ZHoob2004/Polygonus-Universal-112/README.md

# Polygonus-Universal

Basic pinout for the Molex 112 pin plug intended for universal use.  

## NOT COMPATIBLE WITH ANY PNP APPLICATION  
 
## V1.0 ready for first fabrication, please check BOM before fabrication
 
## Pre-Production well tested and proven
