ZHoob2004/Polygonus-Universal-112/kicad-libraries/BOM_related/Kicad_BOM_Not_grouped_Frankenso.png

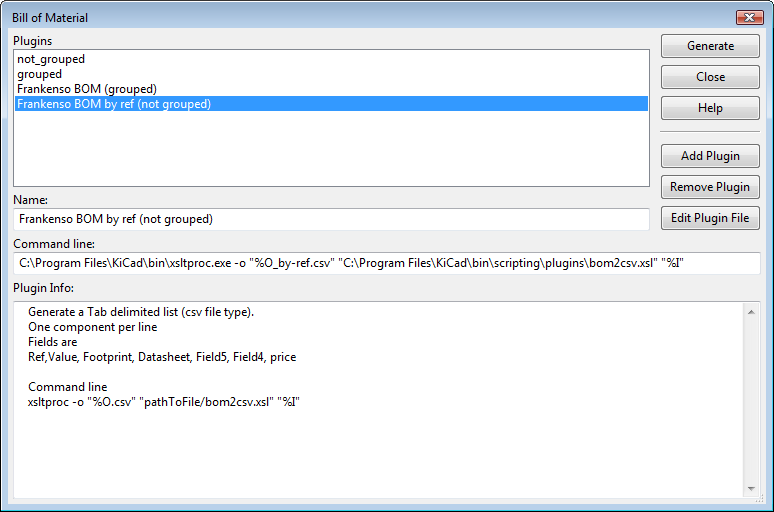
kicad-libraries/BOM_related/Kicad_BOM_Not_grouped_Frankenso.png
