ZHoob2004/Polygonus-Universal-112/CAD/STEP/Base.stp

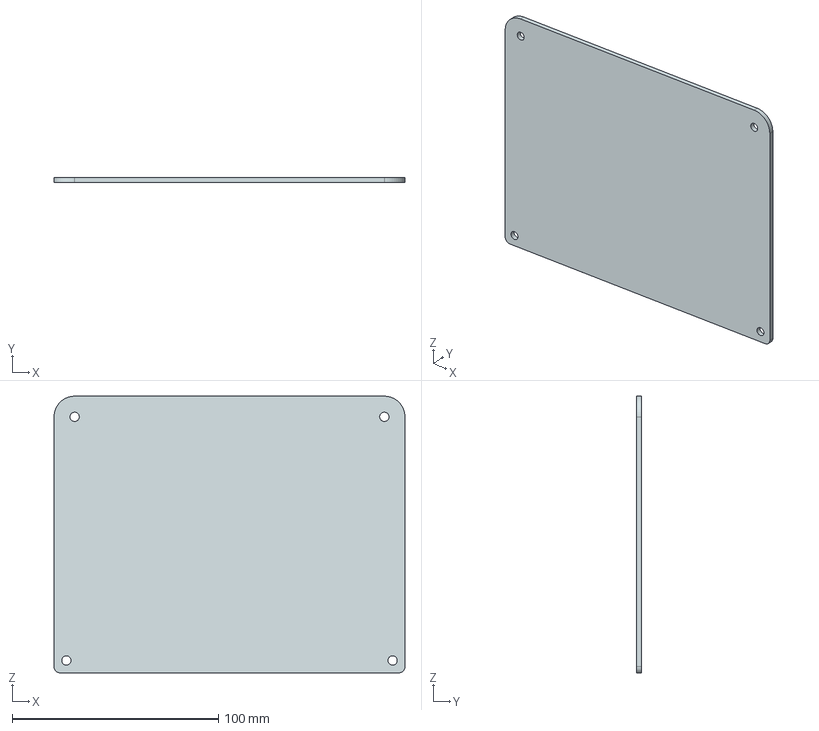
[picture p5: CAD file, 2025-05-16]
CAD/STEP/Base.stp
170.0 x 2.50 x 134.0 mm
