ZHoob2004/Polygonus-Universal-112/kicad-libraries/3d/Misc/drv8880-stepper-motor-driver-carrier.FCStd

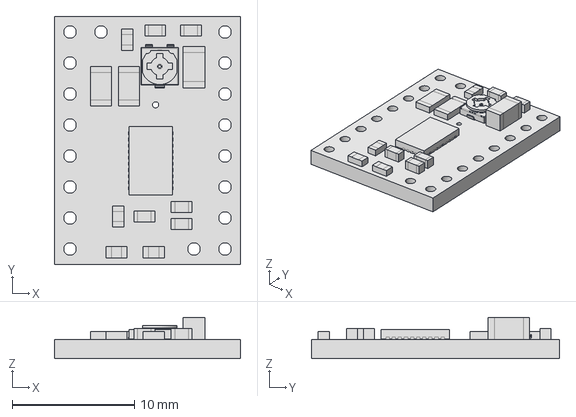
[picture p6: CAD file, 2024-04-05]
kicad-libraries/3d/Misc/drv8880-stepper-motor-driver-carrier.FCStd
15.2 x 20.3 x 3.37 mm
