ZHoob2004/Polygonus-Universal-112/kicad-libraries/3d/TSOP-6.step

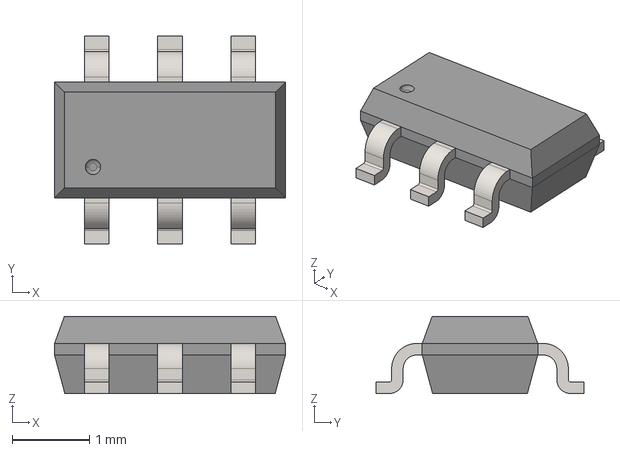
[picture p7: CAD file, 2024-04-05]
kicad-libraries/3d/TSOP-6.step
3.00 x 2.70 x 1.00 mm
