ZHoob2004/Polygonus-Universal-112/CAD/STEP/PCB.stp

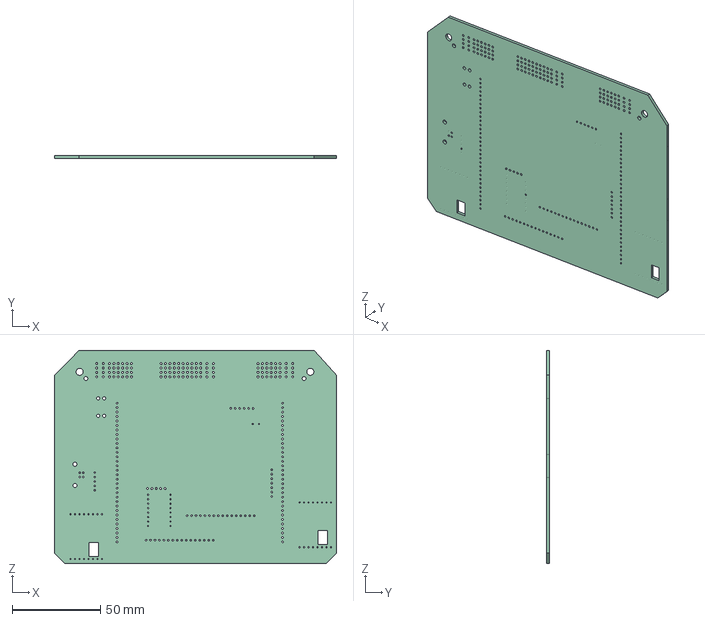
[picture p8: CAD file, 2025-05-16]
CAD/STEP/PCB.stp
160.0 x 1.58 x 121.0 mm
