ZHoob2004/Polygonus-Universal-112/kicad-libraries/3d/Misc/a4988-stepper-motor-driver-carrier.FCStd

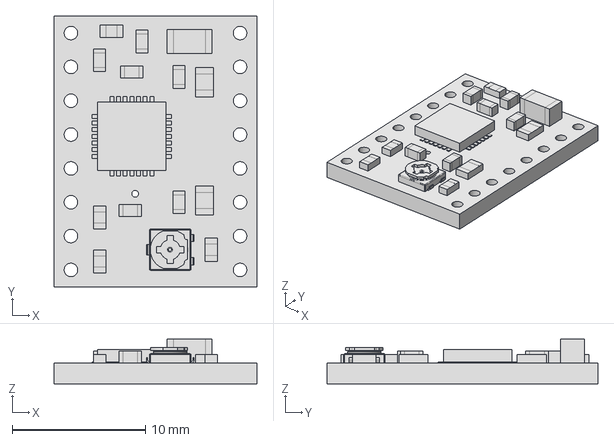
[picture p9: CAD file, 2024-04-05]
kicad-libraries/3d/Misc/a4988-stepper-motor-driver-carrier.FCStd
15.2 x 20.3 x 3.37 mm
