ZHoob2004/Polygonus-Universal-112/kicad-libraries/3d/TCPL_CONNECTOR_PCC-SMP.step

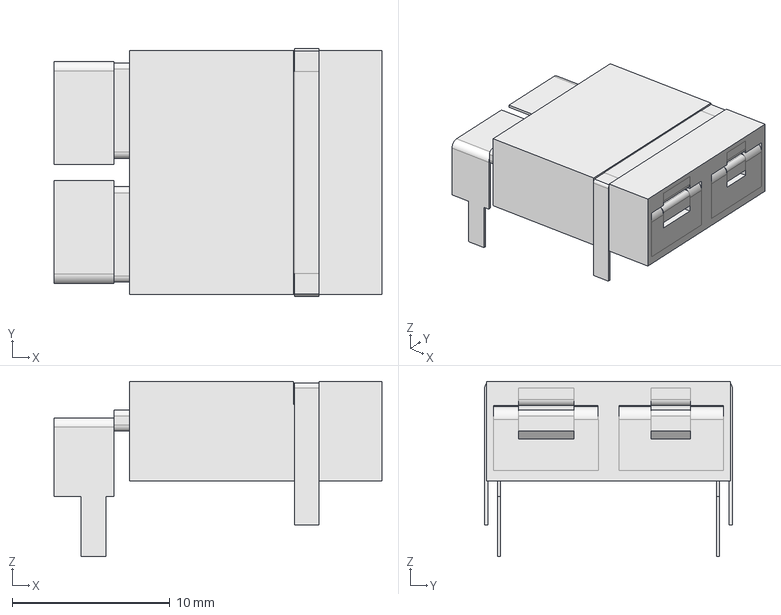
[picture p10: CAD file, 2024-04-05]
kicad-libraries/3d/TCPL_CONNECTOR_PCC-SMP.step
20.8 x 15.7 x 11.1 mm
