ZHoob2004/Polygonus-Universal-112/kicad-libraries/3d/c-1-776231-1-d-3d.STEP

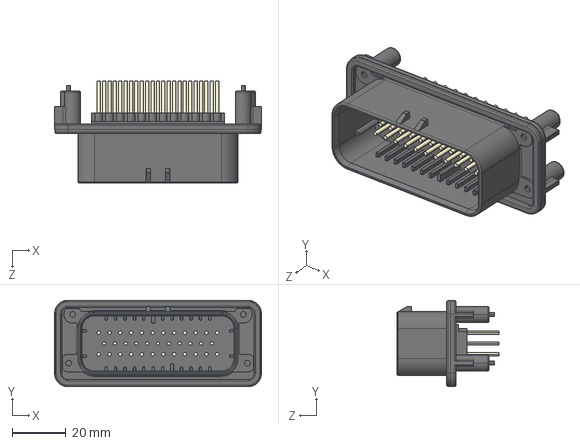
[picture p11: CAD file, 2024-04-05]
kicad-libraries/3d/c-1-776231-1-d-3d.STEP
76.9 x 32.1 x 38.0 mm
