ZHoob2004/Polygonus-Universal-112/CAD/STEP/Upper.stp

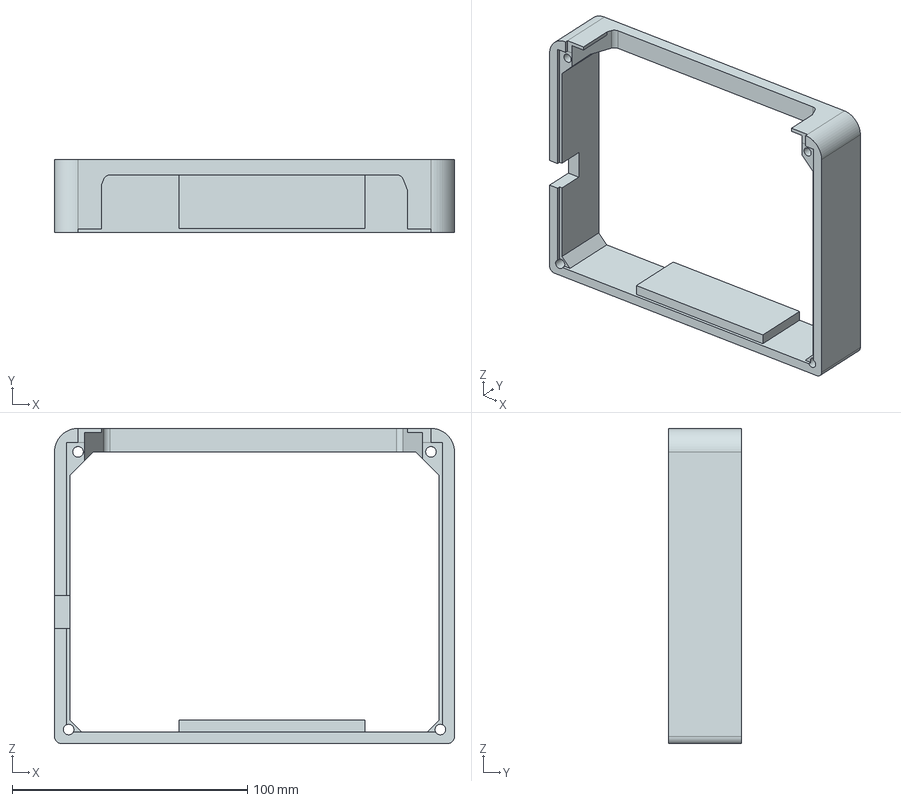
[picture p12: CAD file, 2025-05-16]
CAD/STEP/Upper.stp
170.0 x 31.0 x 134.0 mm
