ZHoob2004/Polygonus-Universal-112/kicad-libraries/3d/tactileswitch-short.step

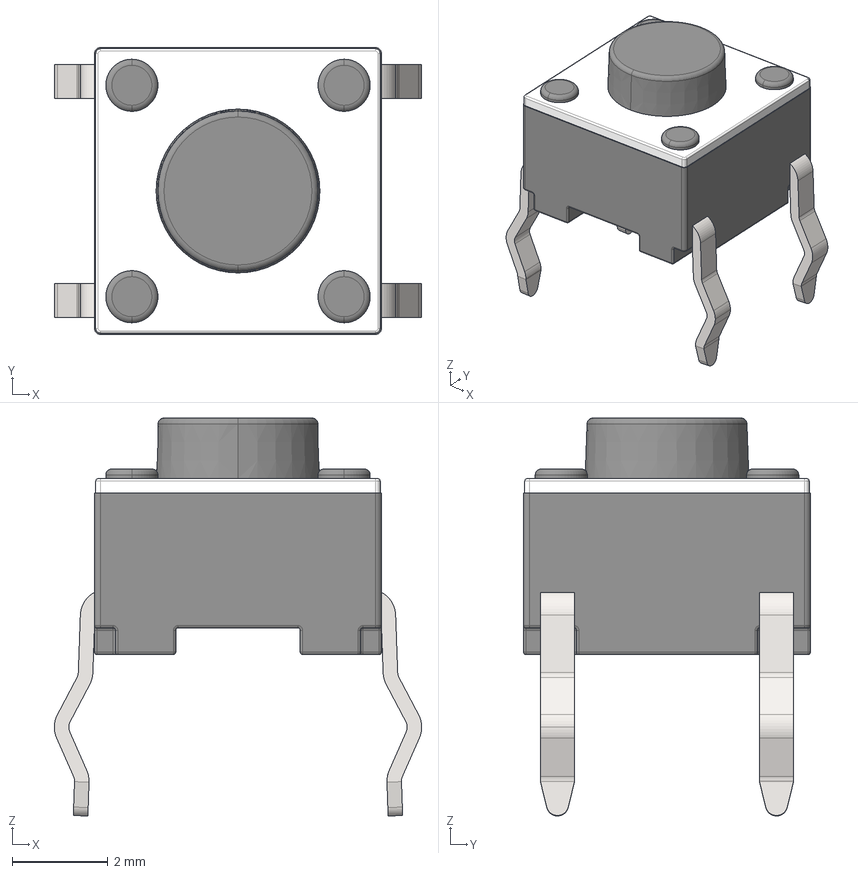
[picture p13: CAD file, 2024-04-05]
kicad-libraries/3d/tactileswitch-short.step
7.69 x 6.01 x 8.33 mm
