ZHoob2004/Polygonus-Universal-112/CAD/STEP/Lower.stp

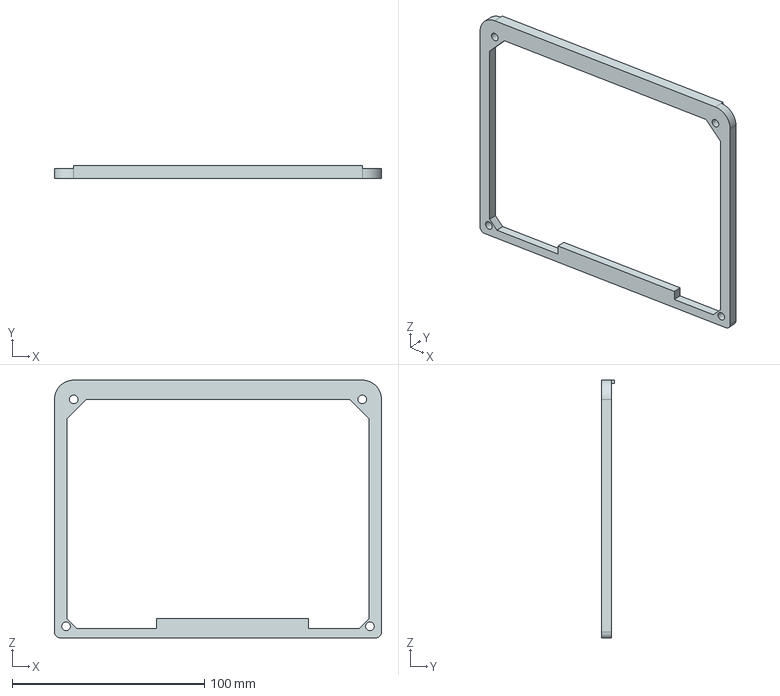
[picture p14: CAD file, 2025-05-16]
CAD/STEP/Lower.stp
170.0 x 6.50 x 134.0 mm
