ZHoob2004/Polygonus-Universal-112/kicad-libraries/3d/BatHolder_SMTU2032.step

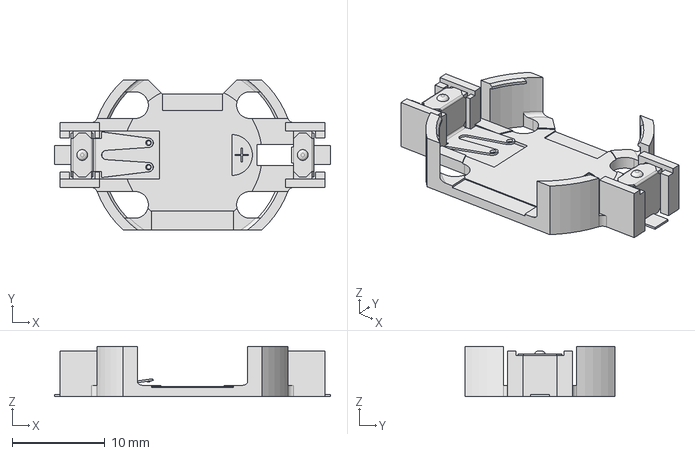
[picture p15: CAD file, 2024-04-05]
kicad-libraries/3d/BatHolder_SMTU2032.step
29.7 x 16.1 x 5.40 mm
