ZHoob2004/Polygonus-Universal-112/kicad-libraries/3d/USB_Vert_C-1734753-1.step

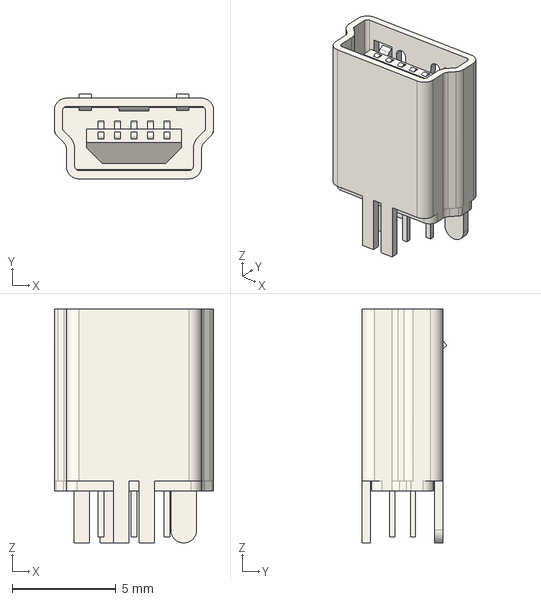
[picture p16: CAD file, 2024-04-05]
kicad-libraries/3d/USB_Vert_C-1734753-1.step
7.70 x 4.09 x 11.3 mm
