ZHoob2004/Polygonus-Universal-112/kicad-libraries/3d/HC18U.step

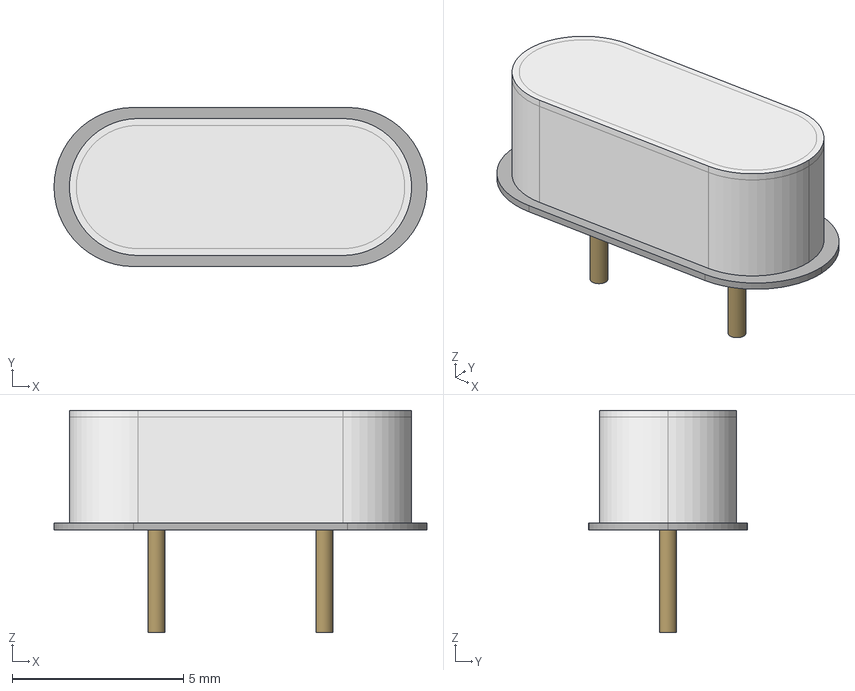
[picture p17: CAD file, 2024-04-05]
kicad-libraries/3d/HC18U.step
10.9 x 4.65 x 6.50 mm
