ZHoob2004/Polygonus-Universal-112/kicad-libraries/3d/MPD_CR2032.STEP

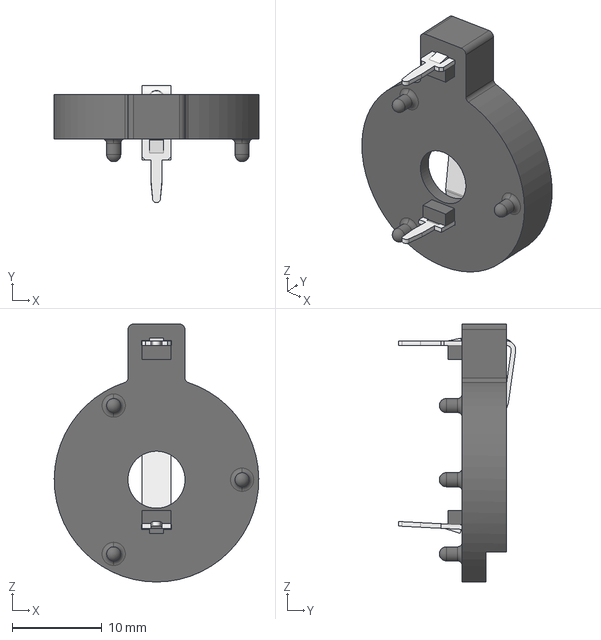
[picture p18: CAD file, 2024-04-05]
kicad-libraries/3d/MPD_CR2032.STEP
22.8 x 13.1 x 28.7 mm
