ZHoob2004/Polygonus-Universal-112/kicad-libraries/3d/itead_hc-05.step

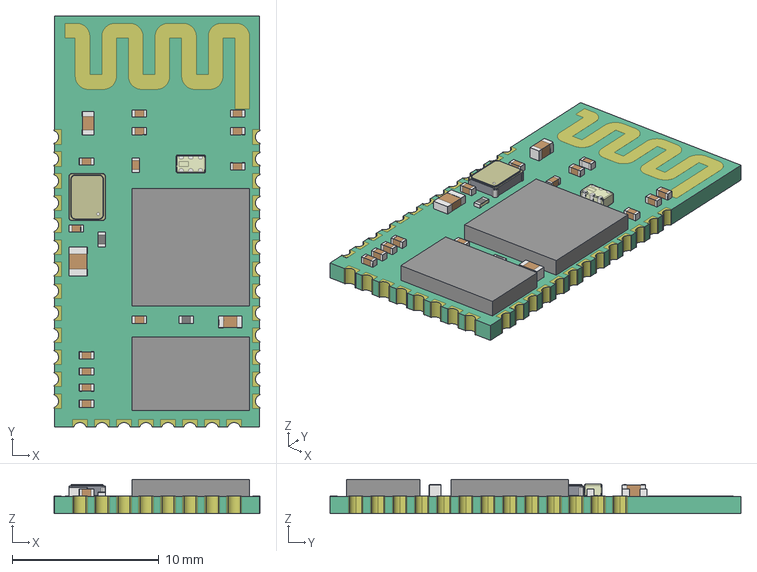
[picture p19: CAD file, 2024-04-05]
kicad-libraries/3d/itead_hc-05.step
14.0 x 28.0 x 2.35 mm
