ZHoob2004/Polygonus-Universal-112/kicad-libraries/3d/AMPSEAL_35_RIGHT_ANGLE.STEP

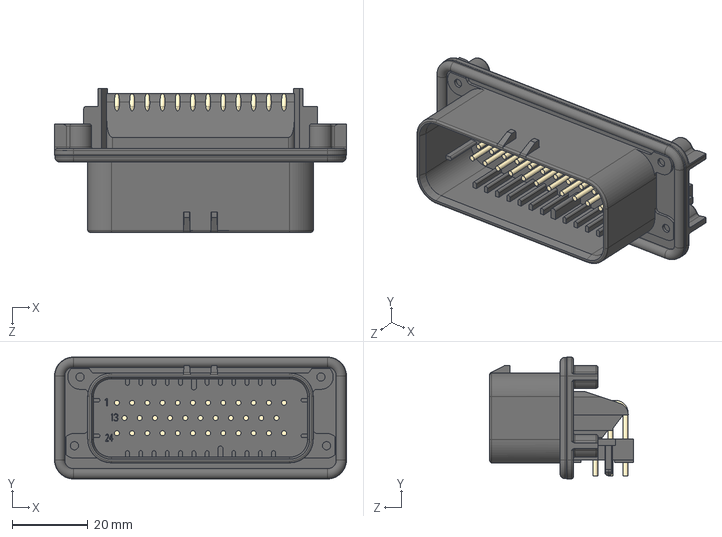
[picture p20: CAD file, 2024-04-05]
kicad-libraries/3d/AMPSEAL_35_RIGHT_ANGLE.STEP
76.9 x 32.1 x 37.8 mm
