ZHoob2004/Polygonus-Universal-112/kicad-libraries/3d/micro_sd.step

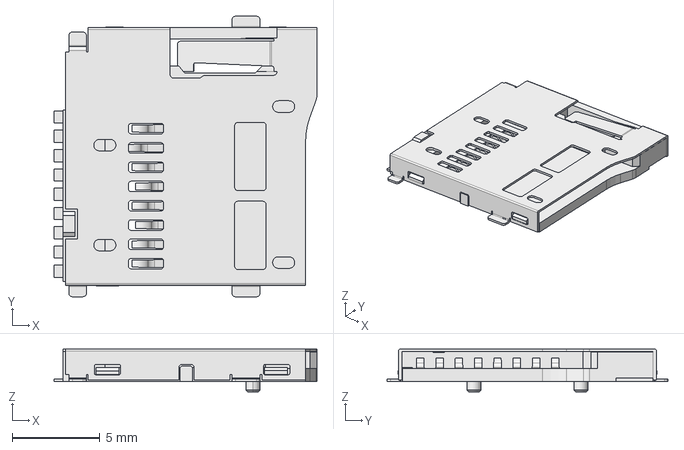
[picture p21: CAD file, 2024-04-05]
kicad-libraries/3d/micro_sd.step
15.0 x 16.0 x 2.44 mm
