ZHoob2004/Polygonus-Universal-112/kicad-libraries/3d/keystone-3557.step

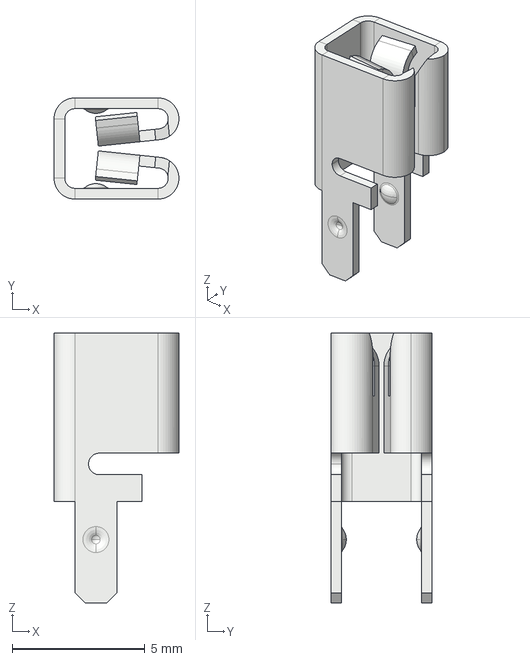
[picture p22: CAD file, 2024-04-05]
kicad-libraries/3d/keystone-3557.step
4.70 x 3.81 x 10.2 mm
