ZHoob2004/Polygonus-Universal-112/kicad-libraries/3d/JoyStick_SKRHAA.step

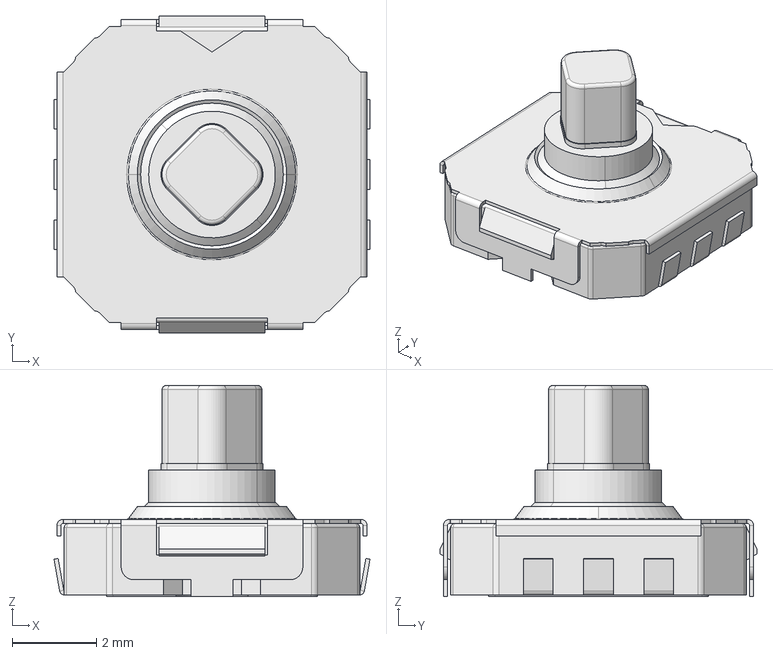
[picture p23: CAD file, 2024-04-05]
kicad-libraries/3d/JoyStick_SKRHAA.step
7.48 x 7.50 x 5.00 mm
