ZHoob2004/Polygonus-Universal-112/kicad-libraries/3d/LCD_20x4.step

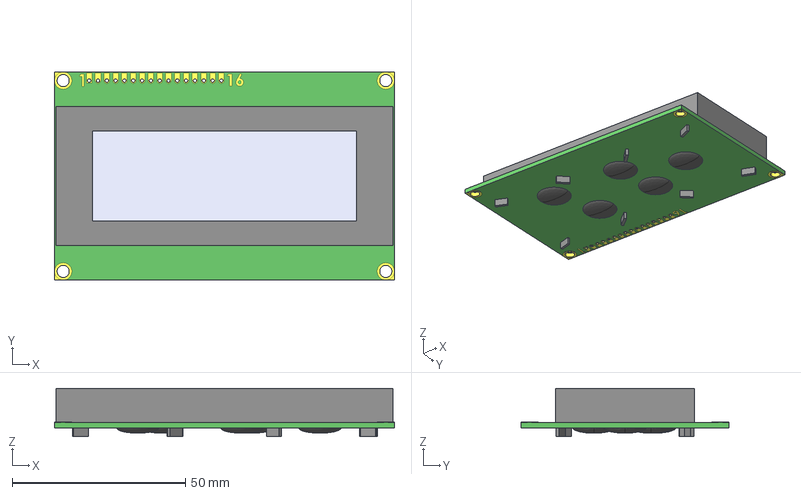
[picture p24: CAD file, 2024-04-05]
kicad-libraries/3d/LCD_20x4.step
98.0 x 60.0 x 13.9 mm
