ZHoob2004/Polygonus-Universal-112/kicad-libraries/3d/LED_0805.step

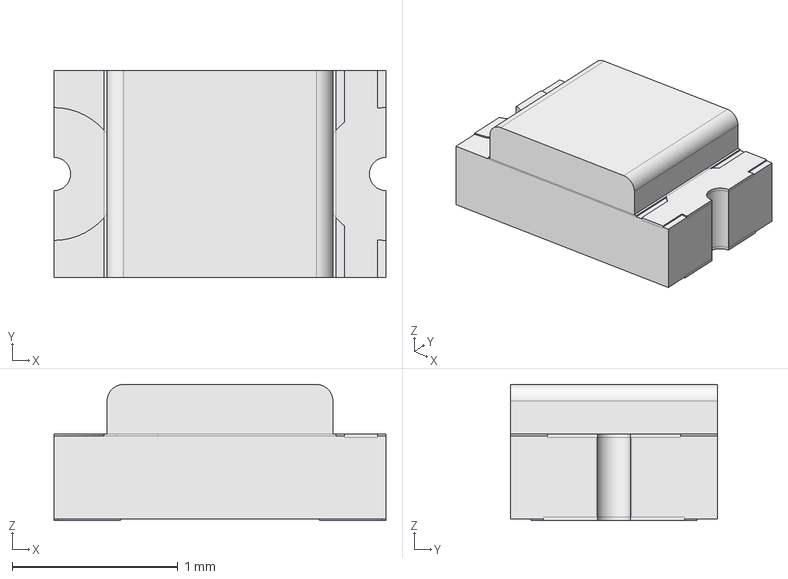
[picture p25: CAD file, 2024-04-05]
kicad-libraries/3d/LED_0805.step
2.00 x 1.25 x 0.82 mm
