ZHoob2004/Polygonus-Universal-112/kicad-libraries/3d/c-1-776228-1-e-3d.STEP

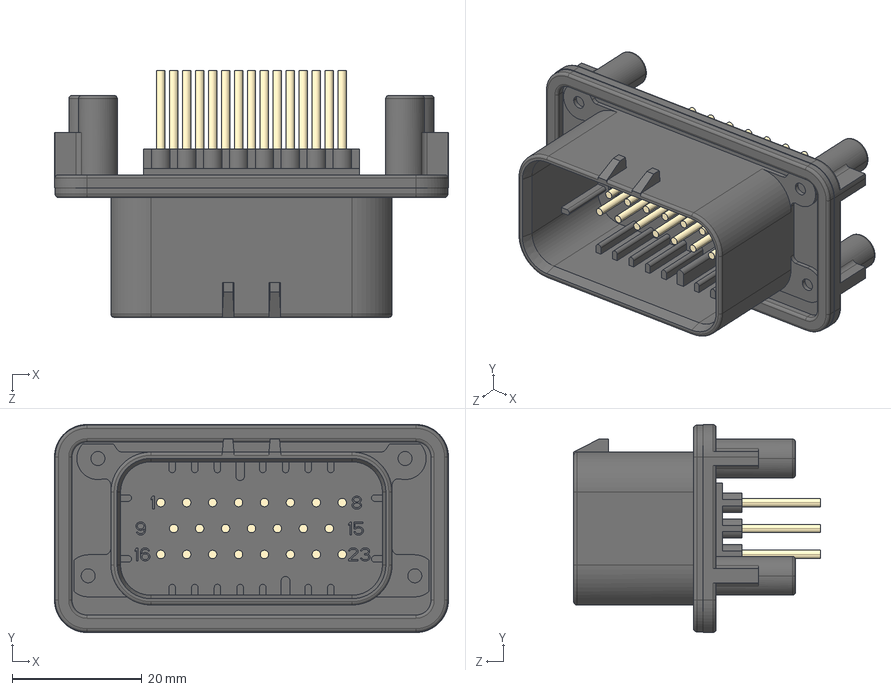
[picture p26: CAD file, 2024-04-05]
kicad-libraries/3d/c-1-776228-1-e-3d.STEP
60.8 x 32.1 x 38.1 mm
