ZHoob2004/Polygonus-Universal-112/(list of files, cad)

Other CAD files:
CAD/STEP/FPP_Lid.stp
kicad-libraries/3d/c-1-776231-2-d-3d.STEP
kicad-libraries/3d/AMPSEAL_35_STRAIGHT.STEP
kicad-libraries/3d/AMPSEAL_23_STRAIGHT.stp
CAD/stl/Base.stl
CAD/stl/FPP_Lid.stl
CAD/stl/Lower.stl
CAD/stl/PCB.stl
CAD/stl/Upper.stl
kicad-libraries/3d/LCD_20x4.FCStd
kicad-libraries/3d/MPD_CR2032.FCStd
kicad-libraries/3d/Misc/a4988-stepper-motor-driver-carrier.stl
kicad-libraries/3d/Misc/drv8880-stepper-motor-driver-carrier.stl
