ZHoob2004/Polygonus-Universal-112/kicad-libraries/HiQUAD64_footprint_builder.png

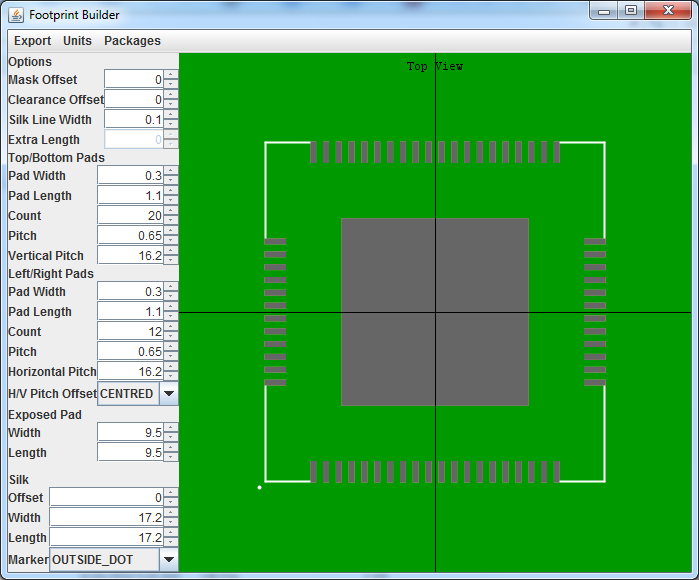
kicad-libraries/HiQUAD64_footprint_builder.png
