ZHoob2004/Polygonus-Universal-112/IGBT outputs.kicad_sch

## KiCad design IGBT outputs.kicad_sch (2025-10-27, an earlier design)

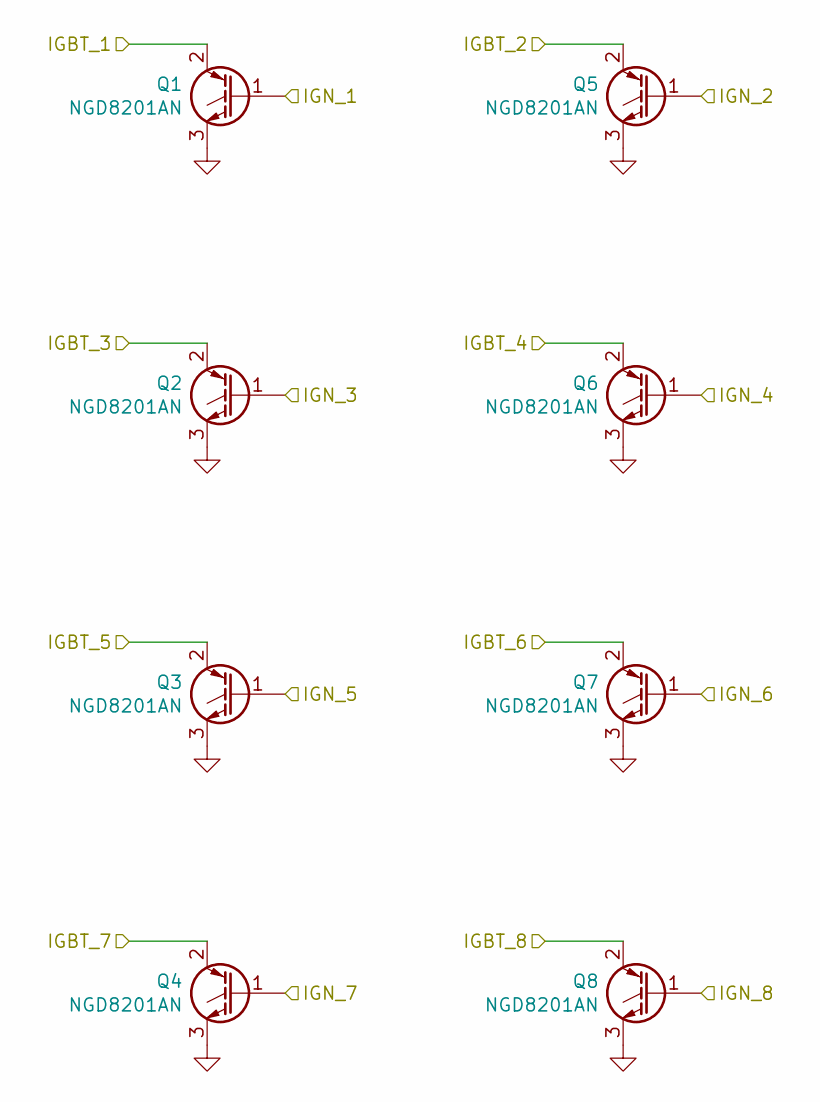
[picture p48: schematic IGBT outputs.kicad_sch]

Parts:
Q1, Q2, Q3, Q4, Q5, Q6, Q7, Q8: NGD8201AN; TO-252-2; LCSC C151649

Connections:
GND: Q1.3 (E), Q2.3 (E), Q3.3 (E), Q4.3 (E), Q5.3 (E), Q6.3 (E), Q7.3 (E), Q8.3 (E)
IGBT_1: Q1.2 (C)
IGBT_2: Q5.2 (C)
IGBT_3: Q2.2 (C)
IGBT_4: Q6.2 (C)
IGBT_5: Q3.2 (C)
IGBT_6: Q7.2 (C)
IGBT_7: Q4.2 (C)
IGBT_8: Q8.2 (C)
IGN_1: Q1.1 (G)
IGN_2: Q5.1 (G)
IGN_3: Q2.1 (G)
IGN_4: Q6.1 (G)
IGN_5: Q3.1 (G)
IGN_6: Q7.1 (G)
IGN_7: Q4.1 (G)
IGN_8: Q8.1 (G)
