ZHoob2004/Polygonus-Universal-112/Lowside Adder.kicad_sch

## KiCad design Lowside Adder.kicad_sch (2025-10-27, an earlier design)

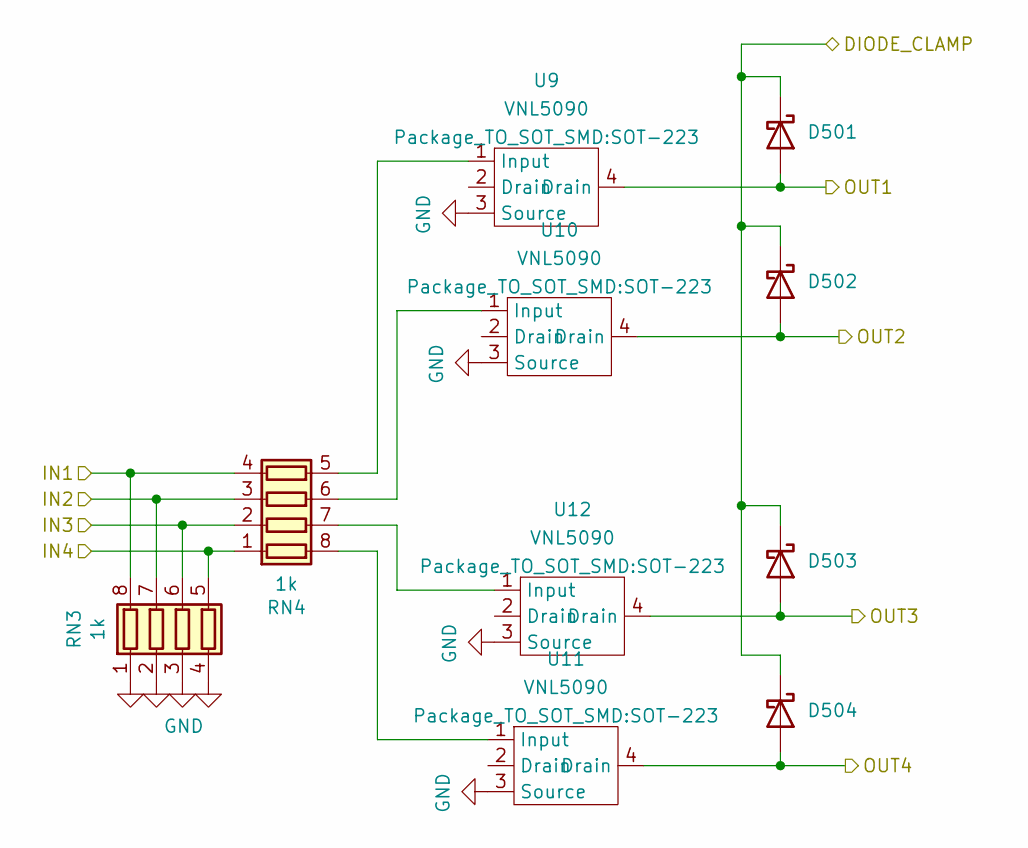
[picture p49: schematic Lowside Adder.kicad_sch]

Parts:
D501, D502, D503, D504: D_Schottky; D_SMA
RN3, RN4: 1k; R_Array_Convex_4x0603; LCSC C20197
U9, U10, U11, U12: VNL5090; SOT-223; LCSC C2680415

Connections:
DIODE_CLAMP: D501.1 (K), D502.1 (K), D503.1 (K), D504.1 (K)
GND: RN3.1 (R1.1), RN3.2 (R2.1), RN3.3 (R3.1), RN3.4 (R4.1), U9.3 (Source), U10.3 (Source), U11.3 (Source), U12.3 (Source)
IN1: RN3.8 (R1.2), RN4.4 (R4.1)
IN2: RN3.7 (R2.2), RN4.3 (R3.1)
IN3: RN3.6 (R3.2), RN4.2 (R2.1)
IN4: RN3.5 (R4.2), RN4.1 (R1.1)
unnamed: RN4.5 (R4.2), U9.1 (Input)
unnamed: RN4.6 (R3.2), U10.1 (Input)
unnamed: RN4.7 (R2.2), U12.1 (Input)
unnamed: RN4.8 (R1.2), U11.1 (Input)
OUT1: D501.2 (A), U9.4 (Drain)
OUT2: D502.2 (A), U10.4 (Drain)
OUT3: D503.2 (A), U12.4 (Drain)
OUT4: D504.2 (A), U11.4 (Drain)
