ZHoob2004/Polygonus-Universal-112/Polygonus-Universal-Base.kicad_sch

## KiCad design Polygonus-Universal-Base.kicad_sch (2025-10-27, an earlier design)

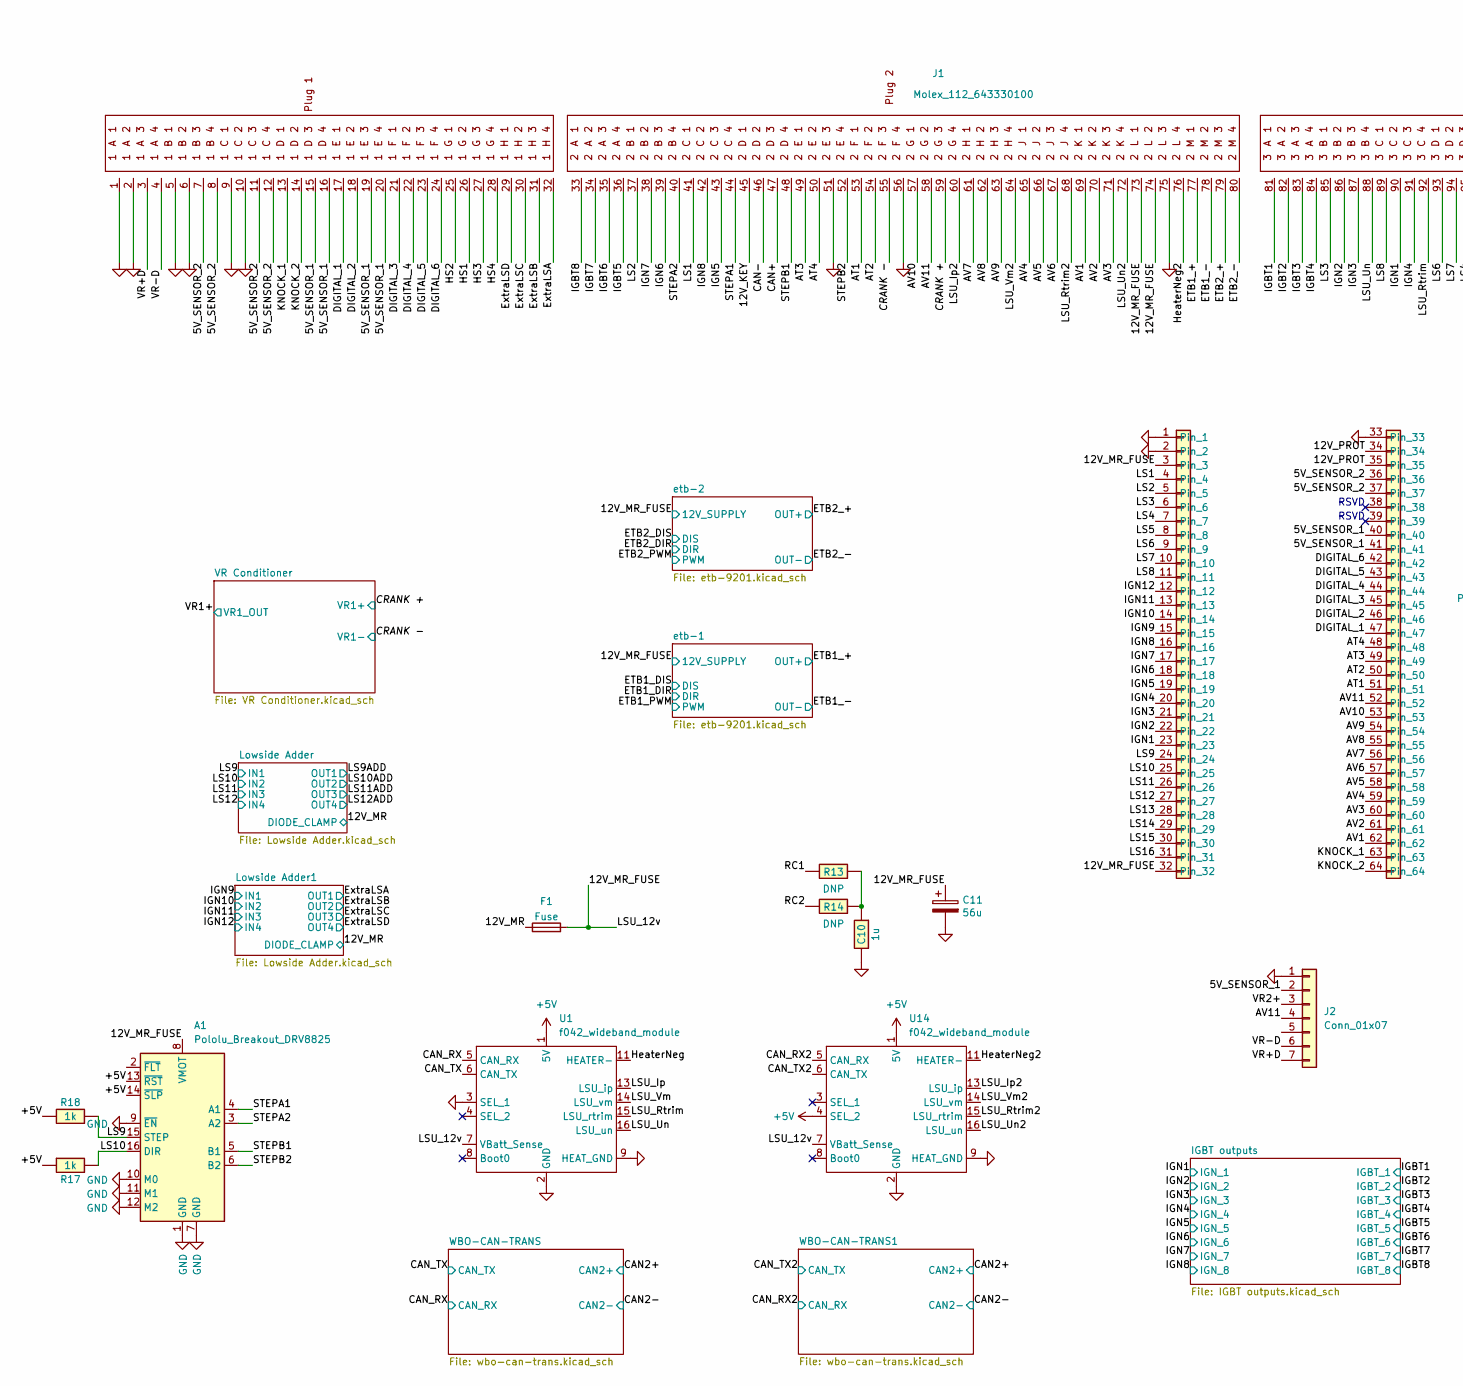
[picture p50: schematic Polygonus-Universal-Base.kicad_sch, part in row 1, column 1]

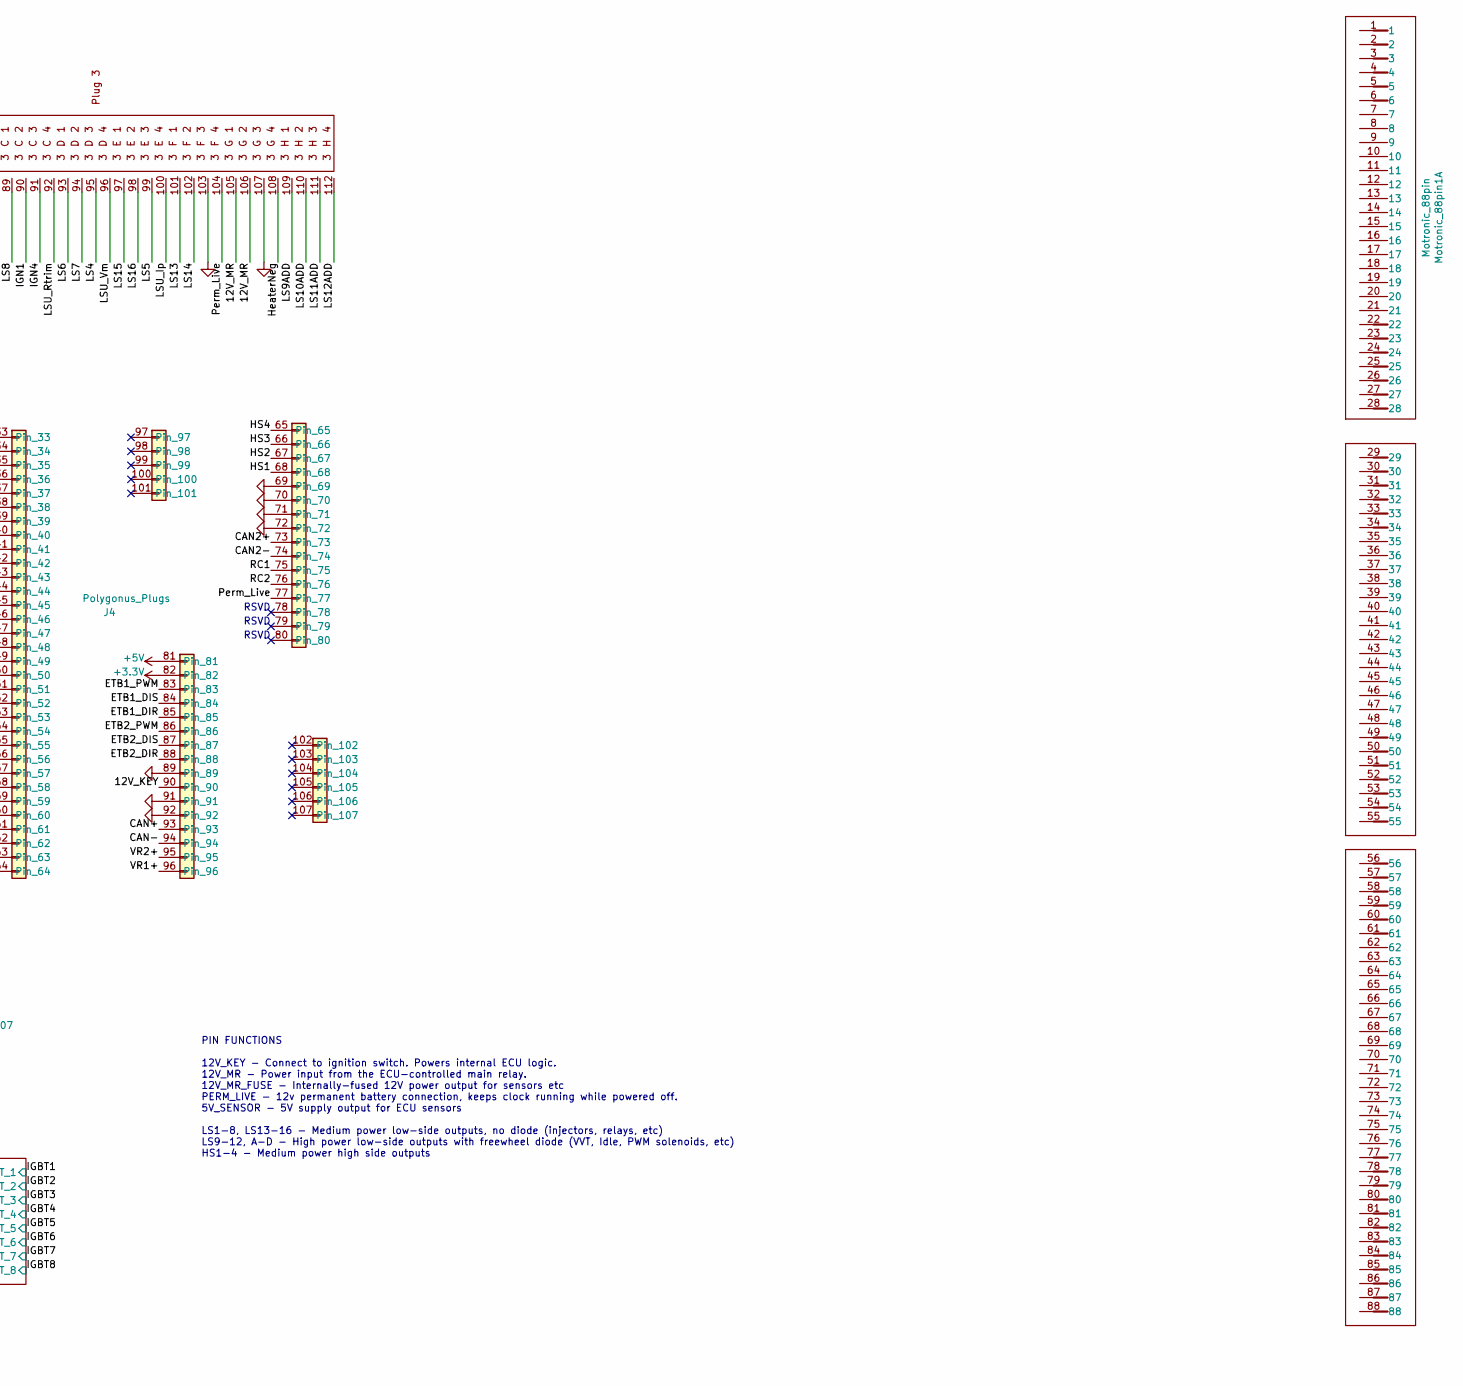
[picture p51: schematic Polygonus-Universal-Base.kicad_sch, part in row 1, column 2]

Parts:
A1: Pololu_Breakout_DRV8825; Pololu_Breakout-16_15.2x20.3mm
C10: 1u; C_0805_2012Metric; LCSC DNP
C11: 56u; CP_Radial_D8.0mm_P3.50mm; LCSC N/A
F1: Fuse; Fuseholder_Blade_Mini_Keystone_3568; LCSC C5249699
J1: Molex_112_643330100
J2: Conn_01x07; PinHeader_1x07_P2.54mm_Vertical
J4: Polygonus_Plugs; Polygonus-With-USB-SWD
Motronic_88pin1: Motronic_88pin; 88Pin Motronic BMW
R13, R14: DNP; R_0805_2012Metric; LCSC DNP
R17, R18: 1k; R_0805_2012Metric; LCSC C21190
U1, U14: f042_wideband_module

Connections:
5V_SENSOR_1: J1.15, J1.16, J1.19, J1.20, J2.2, J4.40, J4.41
5V_SENSOR_2: J1.7, J1.8, J1.11, J1.12, J4.36, J4.37
12V_KEY: J1.45, J4.90
12V_MR: F1.1, J1.105, J1.106
12V_MR_FUSE: A1.8 (VMOT), C11.1, F1.2, J1.73, J1.74, J4.3, J4.32, U1.7 (VBatt_Sense), U14.7 (VBatt_Sense)
12V_PROT: J4.34, J4.35
+3.3V: J4.82
+5V: A1.13 (~RST), A1.14 (~SLP), J4.81, R17.1, R18.2, U1.1 (5V), U14.1 (5V), U14.4 (SEL_2)
AT1: J1.53, J4.51
AT2: J1.54, J4.50
AT3: J1.49, J4.49
AT4: J1.50, J4.48
AV1: J1.69, J4.62
AV2: J1.70, J4.61
AV3: J1.71, J4.60
AV4: J1.65, J4.59
AV5: J1.66, J4.58
AV6: J1.67, J4.57
AV7: J1.61, J4.56
AV8: J1.62, J4.55
AV9: J1.63, J4.54
AV10: J1.57, J4.53
AV11: J1.58, J2.4, J4.52
CAN2+: J4.73
CAN2-: J4.74
CAN+: J1.47, J4.93
CAN-: J1.46, J4.94
CAN_RX: U1.5 (CAN_RX)
CAN_RX2: U14.5 (CAN_RX)
CAN_TX: U1.6 (CAN_TX)
CAN_TX2: U14.6 (CAN_TX)
CRANK +: J1.59
CRANK -: J1.55
DIGITAL_1: J1.17, J4.47
DIGITAL_2: J1.18, J4.46
DIGITAL_3: J1.21, J4.45
DIGITAL_4: J1.22, J4.44
DIGITAL_5: J1.23, J4.43
DIGITAL_6: J1.24, J4.42
ETB1_+: J1.77
ETB1_-: J1.78
ETB1_DIR: J4.85
ETB1_DIS: J4.84
ETB1_PWM: J4.83
ETB2_+: J1.79
ETB2_-: J1.80
ETB2_DIR: J4.88
ETB2_DIS: J4.87
ETB2_PWM: J4.86
ExtraLSA: J1.32
ExtraLSB: J1.31
ExtraLSC: J1.30
ExtraLSD: J1.29
GND: A1.1 (GND), A1.7 (GND), A1.9 (~EN), A1.10 (M0), A1.11 (M1), A1.12 (M2), C10.2, C11.2, J1.1, J1.2, J1.5, J1.6, J1.9, J1.10, J1.51, J1.56, J1.75, J1.103, J1.107, J2.1, J4.1, J4.2, J4.33, J4.69, J4.70, J4.71, J4.72, J4.89, J4.91, J4.92, U1.2 (GND), U1.3 (SEL_1), U1.9 (HEAT_GND), U1.10 (HEAT_GND2), U14.2 (GND), U14.9 (HEAT_GND), U14.10 (HEAT_GND2)
HS1: J1.26, J4.68
HS2: J1.25, J4.67
HS3: J1.27, J4.66
HS4: J1.28, J4.65
HeaterNeg: J1.108, U1.11 (HEATER-), U1.12 (HEATER-)
HeaterNeg2: J1.76, U14.11 (HEATER-), U14.12 (HEATER-)
IGBT1: J1.81
IGBT2: J1.82
IGBT3: J1.83
IGBT4: J1.84
IGBT5: J1.36
IGBT6: J1.35
IGBT7: J1.34
IGBT8: J1.33
IGN1: J1.90, J4.23
IGN2: J1.86, J4.22
IGN3: J1.87, J4.21
IGN4: J1.91, J4.20
IGN5: J1.43, J4.19
IGN6: J1.39, J4.18
IGN7: J1.38, J4.17
IGN8: J1.42, J4.16
IGN9: J4.15
IGN10: J4.14
IGN11: J4.13
IGN12: J4.12
KNOCK_1: J1.13, J4.63
KNOCK_2: J1.14, J4.64
LS1: J1.41, J4.4
LS2: J1.37, J4.5
LS3: J1.85, J4.6
LS4: J1.95, J4.7
LS5: J1.99, J4.8
LS6: J1.93, J4.9
LS7: J1.94, J4.10
LS8: J1.89, J4.11
LS9: A1.15 (STEP), J4.24, R18.1
LS9ADD: J1.109
LS10: A1.16 (DIR), J4.25, R17.2
LS10ADD: J1.110
LS11: J4.26
LS11ADD: J1.111
LS12: J4.27
LS12ADD: J1.112
LS13: J1.101, J4.28
LS14: J1.102, J4.29
LS15: J1.97, J4.30
LS16: J1.98, J4.31
LSU_Ip: J1.100, U1.13 (LSU_ip)
LSU_Ip2: J1.60, U14.13 (LSU_ip)
LSU_Rtrim: J1.92, U1.15 (LSU_rtrim)
LSU_Rtrim2: J1.68, U14.15 (LSU_rtrim)
LSU_Un: J1.88, U1.16 (LSU_un)
LSU_Un2: J1.72, U14.16 (LSU_un)
LSU_Vm: J1.96, U1.14 (LSU_vm)
LSU_Vm2: J1.64, U14.14 (LSU_vm)
unnamed: C10.1, R13.1, R14.1
Perm_Live: J1.104, J4.77
RC1: J4.75, R13.2
RC2: J4.76, R14.2
STEPA1: A1.4 (A1), J1.44
STEPA2: A1.3 (A2), J1.40
STEPB1: A1.5 (B1), J1.48
STEPB2: A1.6 (B2), J1.52
VR1+: J4.96
VR2+: J2.3, J4.95
VR+D: J1.3, J2.7
VR-D: J1.4, J2.6

Notes on the sheet:
PIN FUNCTIONS 12V_KEY - Connect to ignition switch. Powers internal ECU logic. 12V_MR - Power input from the ECU-controlled main relay. 12V_MR_FUSE - Internally-fused 12V power output for sensors etc PERM_LIVE - 12v permanent battery connection, keeps clock running while powered off. 5V_SENSOR - 5V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
RSVD
