ZHoob2004/Polygonus-Universal-112/VR conditioner.kicad_sch

## KiCad design VR conditioner.kicad_sch (2025-10-27, an earlier design)

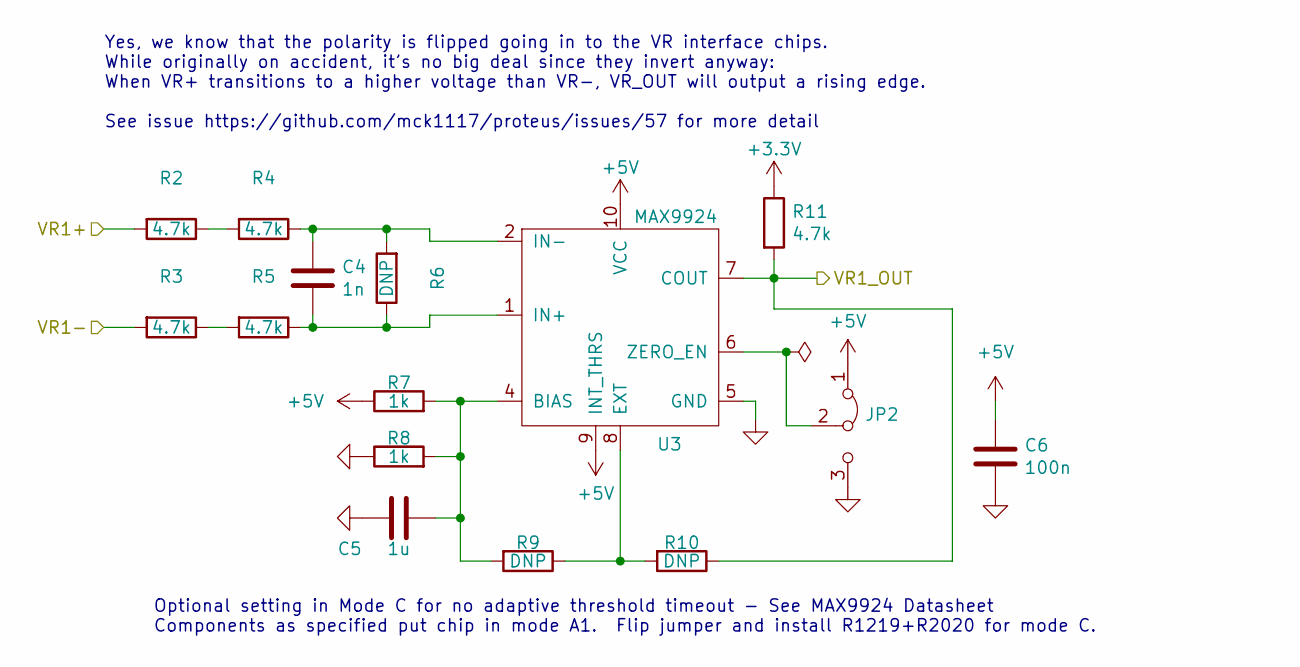
[picture p52: schematic VR conditioner.kicad_sch]

Parts:
C4: 1n; C_0805_2012Metric; LCSC C46653
C5: 1u; C_0805_2012Metric; LCSC C28323
C6: 100n; C_0805_2012Metric_Pad1.18x1.45mm_HandSolder; LCSC C28323
JP2: Jumper_3_Bridged12; SolderJumper-3_P1.3mm_Bridged12_RoundedPad1.0x1.5mm; LCSC N/A
R2, R3, R4, R5, R11: 4.7k; R_0805_2012Metric; LCSC C17673
R6: DNP; R_0805_2012Metric; LCSC DNP
R7, R8: 1k; R_0805_2012Metric; LCSC C17513
R9, R10: DNP; R_0805_2012Metric_Pad1.20x1.40mm_HandSolder; LCSC DNP
U3: MAX9924; MSOP-10_3x3mm_P0.5mm; LCSC C143633

Connections:
+3.3V: R11.1
+5V: C6.1, JP2.1 (A), R7.1, U3.9 (INT_THRS), U3.10 (VCC)
GND: C5.2, C6.2, JP2.3 (B), R8.1, U3.5 (GND)
unnamed: C4.1, R4.1, R6.2, U3.2 (IN-)
unnamed: C4.2, R5.1, R6.1, U3.1 (IN+)
unnamed: C5.1, R7.2, R8.2, R9.2, U3.4 (BIAS)
unnamed: JP2.2 (C), U3.6 (ZERO_EN)
unnamed: R2.1, R4.2
unnamed: R3.1, R5.2
unnamed: R9.1, R10.2, U3.8 (EXT)
VR1+: R2.2
VR1-: R3.2
VR1_OUT: R10.1, R11.2, U3.7 (COUT)

Notes on the sheet:
Optional setting in Mode C for no adaptive threshold timeout - See MAX9924 Datasheet Components as specified put chip in mode A1. Flip jumper and install R1219+R2020 for mode C.
Yes, we know that the polarity is flipped going in to the VR interface chips. While originally on accident, it’s no big deal since they invert anyway: When VR+ transitions to a higher voltage than VR-, VR_OUT will output a rising edge. See issue https://github.com/mck1117/proteus/issues/57 for more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
