ZHoob2004/Polygonus-Universal-112/etb-9201.kicad_sch

## KiCad design etb-9201.kicad_sch (2025-10-27, an earlier design)

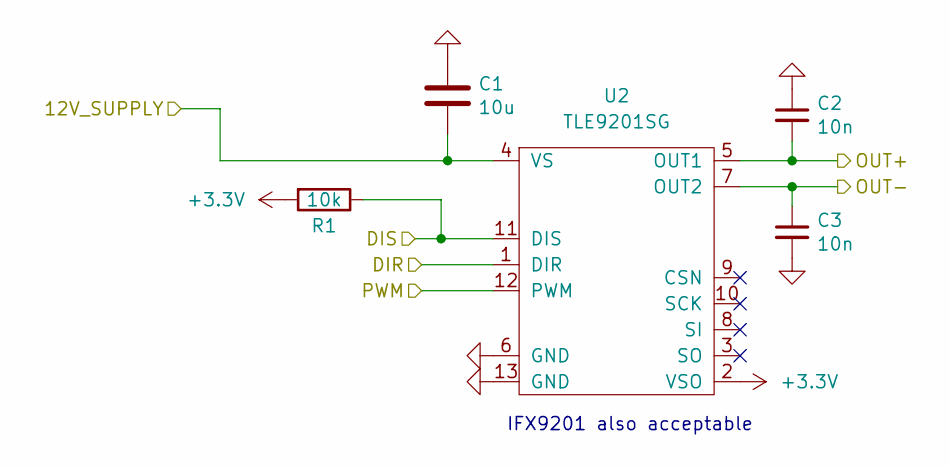
[picture p53: schematic etb-9201.kicad_sch]

Parts:
C1: 10u; C_1206_3216Metric; LCSC C13585
C2, C3: 10n; C_0805_2012Metric; LCSC C1710
R1: 10k; R_0805_2012Metric; LCSC C17414
U2: TLE9201SG; Infineon_PG-DSO-12-9; LCSC C112633

Connections:
12V_SUPPLY: C1.2, U2.4 (VS)
+3.3V: R1.2, U2.2 (VSO)
DIR: U2.1 (DIR)
DIS: R1.1, U2.11 (DIS)
GND: C1.1, C2.1, C3.2, U2.6 (GND), U2.13 (GND)
OUT+: C2.2, U2.5 (OUT1)
OUT-: C3.1, U2.7 (OUT2)
PWM: U2.12 (PWM)

Notes on the sheet:
IFX9201 also acceptable
