ZHoob2004/Polygonus-Universal-112/triggers.kicad_sch

## KiCad design triggers.kicad_sch (2024-04-05)

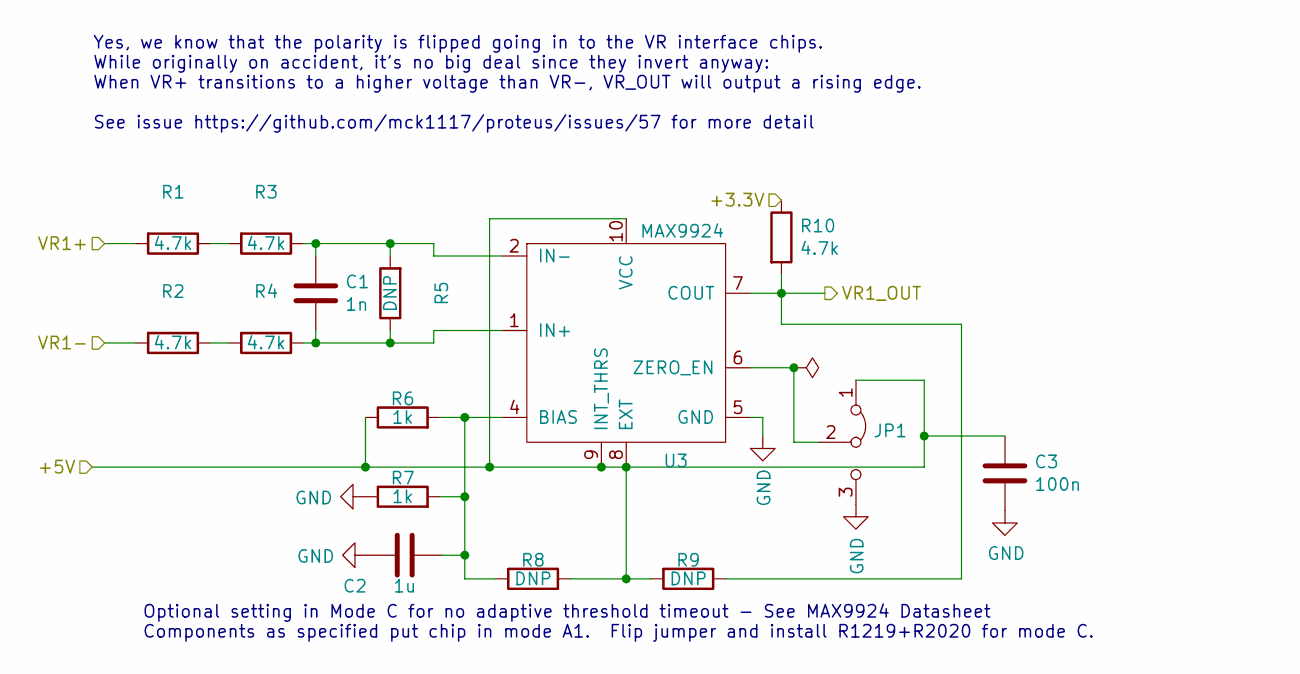
[picture p54: schematic triggers.kicad_sch]

Parts:
C1: 1n; C_0603_1608Metric; LCSC C1588
C2: 1u; C_0603_1608Metric; LCSC C15849
C3: 100n; C_0603_1608Metric; LCSC C14663
JP1: Jumper_3_Bridged12; SolderJumper-3_P1.3mm_Bridged12_RoundedPad1.0x1.5mm; LCSC N/A
R1, R2, R3, R4, R10: 4.7k; R_0805_2012Metric; LCSC C17673
R5: DNP; R_0805_2012Metric; LCSC DNP
R6, R7: 1k; R_0402_1005Metric; LCSC C11702
R8, R9: DNP; R_0805_2012Metric_Pad1.15x1.40mm_HandSolder; LCSC DNP
U3: MAX9924; MSOP-10_3x3mm_P0.5mm; LCSC N/A

Connections:
+3.3V: R10.1
+5V: C3.1, JP1.1 (A), R6.1, R8.1, R9.2, U3.8 (EXT), U3.9 (INT_THRS), U3.10 (VCC)
GND: C2.2, C3.2, JP1.3 (B), R7.1, U3.5 (GND)
unnamed: C1.1, R3.1, R5.2, U3.2 (IN-)
unnamed: C1.2, R4.1, R5.1, U3.1 (IN+)
unnamed: C2.1, R6.2, R7.2, R8.2, U3.4 (BIAS)
unnamed: JP1.2 (C), U3.6 (ZERO_EN)
unnamed: R1.1, R3.2
unnamed: R2.1, R4.2
VR1+: R1.2
VR1-: R2.2
VR1_OUT: R9.1, R10.2, U3.7 (COUT)

Notes on the sheet:
Optional setting in Mode C for no adaptive threshold timeout - See MAX9924 Datasheet Components as specified put chip in mode A1. Flip jumper and install R1219+R2020 for mode C.
Yes, we know that the polarity is flipped going in to the VR interface chips. While originally on accident, it’s no big deal since they invert anyway: When VR+ transitions to a higher voltage than VR-, VR_OUT will output a rising edge. See issue https://github.com/mck1117/proteus/issues/57 for more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
