ZHoob2004/Polygonus-Universal-112/wbo-can-trans.kicad_sch

## KiCad design wbo-can-trans.kicad_sch (2025-10-27, an earlier design)

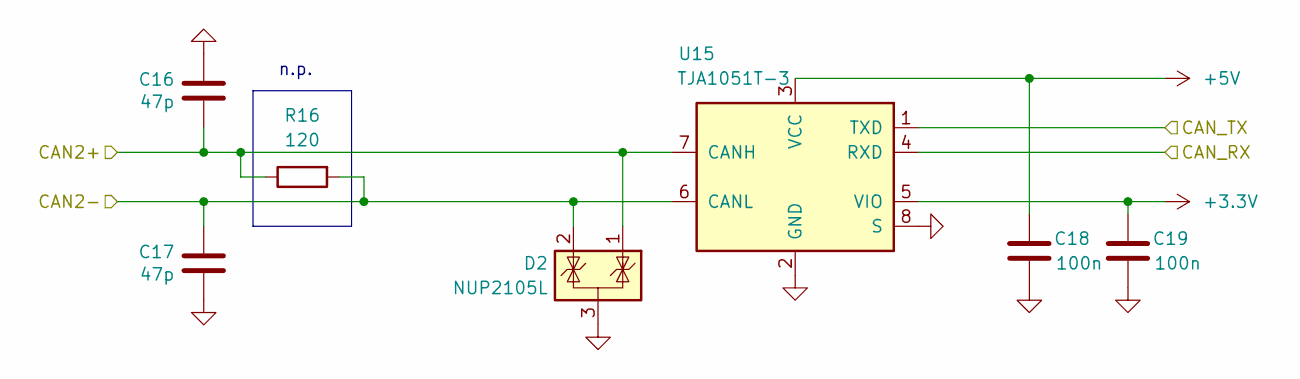
[picture p56: schematic wbo-can-trans.kicad_sch]

Parts:
C16, C17: 47p; C_0805_2012Metric; LCSC C14857
C18, C19: 100n; C_0805_2012Metric; LCSC C49678
D2: NUP2105L; SOT-23; LCSC C284104
R16: 120; R_1206_3216Metric; LCSC C176250
U15: TJA1051T-3; SOIC-8_3.9x4.9mm_P1.27mm; LCSC C38695

Connections:
+3.3V: C19.1, U15.5 (VIO)
+5V: C18.1, U15.3 (VCC)
CAN2+: C16.2, D2.1 (K), R16.1, U15.7 (CANH)
CAN2-: C17.1, D2.2 (K), R16.2, U15.6 (CANL)
CAN_RX: U15.4 (RXD)
CAN_TX: U15.1 (TXD)
GND: C16.1, C17.2, C18.2, C19.2, D2.3 (A), U15.2 (GND), U15.8 (S)

Notes on the sheet:
n.p.
