ZHoob2004/Polygonus-Universal-112/(commit log)

2024-04-05 Made basically all the changes
    [AMPSEAL_23_STRAIGHT.stp, AMPSEAL_35_RIGHT_ANGLE.STEP, AMPSEAL_35_STRAIGHT.STEP, BOM-Polygonus-Universal-Base.csv, BatHolder_SMTU2032.step, Festiva_ECU_PCB_outline.brd, HC18U.step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]
2024-04-21 fixing routing and footprint
    [Polygonus-Universal-Base 1.prt, Polygonus-Universal-Base PCB.prt, Polygonus-Universal-Base PCB32.prt, Polygonus-Universal-Base.step, Polygonus-Universal-Base2.step, Polygonus-Universal-Base2_step.prt, Polygonus-Universal-Base3.step, Polygonus-Universal-Base3_step.prt]
2024-04-22 Getting closer
    finished off the main connector, added USB, created case
    [Base.stl, Lower.stl, Polygonus-Universal-112-Case.prt, Polygonus-Universal-Base 1.prt, Polygonus-Universal-Base PCB.prt, Polygonus-Universal-Base PCB32.prt, Polygonus-Universal-Base-V3.step, Polygonus-Universal-Base-V3_step.prt]
2024-04-25 Added vias, did some DRC checks
    [Polygonus-Universal-Base.kicad_sch]
2024-05-06 Changes to discrete VR
    [IGBT outputs.kicad_sch, Lowside Adder.kicad_sch, Polygonus-Universal-Base.kicad_sch, VR conditioner.kicad_sch, etb-9201.kicad_sch, vr_module_poly.kicad_sch, wbo-can-trans.kicad_sch]
2024-05-07 VR added to base board
    [Polygonus-Universal-112-Case.prt, vr_module_poly.kicad_sch]
2024-05-09 Deleted the old exports
    [BOM-Polygonus-Universal-Base.csv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]
2024-05-12 Added a through hole for the VR and passed DRC
    Need to review and publish a gerb
    [Polygonus-Universal-Base.kicad_sch]
2024-06-01 Tweaked STL files
    [FPP_Lid.stl, Lower.stl, Polygonus-Universal-112-Case.prt, Upper.stl]
2024-06-01 added STLs for whole unit, plug and pcb
    [PCB.stl]
2024-06-05 Added Gerbs and unchecked BOM
    [BOM-Polygonus-Universal-Base.csv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]
2024-06-06 fixed bom and cpl
    [BOM-Polygonus-Universal-Base.csv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]
2024-06-16 added suggested wiring
2025-01-21 fixed plug pin numbering error
    [Polygonus-Universal-Base.kicad_sch]
2025-04-27 Fixed ticket 9 and 7
    [Polygonus-Universal-112-Case.prt, Upper.stl]
2025-04-28 fixed issues: 10, 6, 5, 4 and 2
    [IGBT outputs.kicad_sch, Lowside Adder.kicad_sch, Polygonus-Universal-Base.kicad_sch, VR conditioner.kicad_sch, etb-9201.kicad_sch, vr_module_poly.kicad_sch, wbo-can-trans.kicad_sch]
2025-04-28 moved cad files into folders
    [Base.stl, FPP_Lid.stl, Lower.stl, PCB.stl, Polygonus-Universal-112-Case.prt, Polygonus-Universal-Base PCB.prt, Polygonus-Universal-Base PCB32.prt, Polygonus-Universal-Base-V3.step]
2025-05-16 Added STEP files
    [Base.stp, FPP_Lid.stp, Lower.stp, PCB.stp, Upper.stp]
2025-07-16 V1.0 published
    [Lowside Adder.kicad_sch, Polygonus-Universal-112-Case.prt, Polygonus-Universal-Base PCB.prt, Polygonus-Universal-Base PCB32.prt, Polygonus-Universal-Base-V3.step, Polygonus-Universal-Base-V3_step.prt, Polygonus-Universal-Base.kicad_sch, Polygonus-Universal-Base.step]
2025-07-19 Fixed folder names so they were not auto-ignored
    [BOM-Polygonus-Universal-Base.csv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]
2025-07-30 small mods to fix new main plug holes, rev up to V1.01
2025-10-27 Fixed trigger scope
    [IGBT outputs.kicad_sch, Lowside Adder.kicad_sch, Polygonus-Universal-Base.kicad_sch, VR conditioner.kicad_sch, etb-9201.kicad_sch, vr_module_poly.kicad_sch, wbo-can-trans.kicad_sch]
2025-10-28 Edge fix 2 : smooth brain boogaloo
    New gerbs and pdf for the V1.1 version and actually fixed the outline
    [BOM-Polygonus-Universal-Base.csv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]
